Anyboard/anypawn/demo-apps/demo-anyPawn/README.md

# Anyboard Demo App

Demonstrates the basic functioning of the Anyboard Pawn and Printer

## Setup

### Required hardware

- Anybaord Pawn

### Download and install Evothings
- Install [Evothings](https://evothings.com/download/) on your PC/Mac
- Install [Evothings](https://evothings.com/download/) app on your phone.

### Connect to Evothings
- Open Evothing on your PC
- Drag the index.html file into [Evothings](http://evothings.com) workbench.
- Open Evothings app on your phone
- Connect to workbench running on PC
- Run the example app from Evothings Workbench
