Anyboard/anypawn/case/anypawn_colorsensor_mask.stl

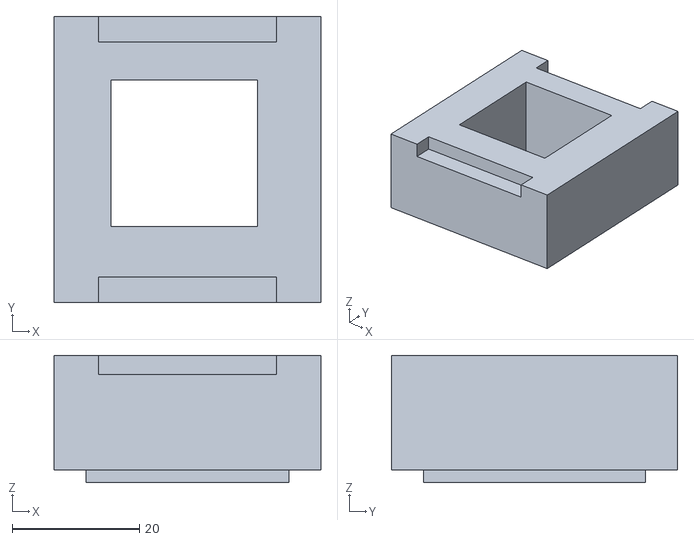
[picture p3: CAD file, 2018-01-28]
case/anypawn_colorsensor_mask.stl
42.0 x 45.0 x 20.0
