Anyboard/anypawn/case/anypawn_case_formlab.stl

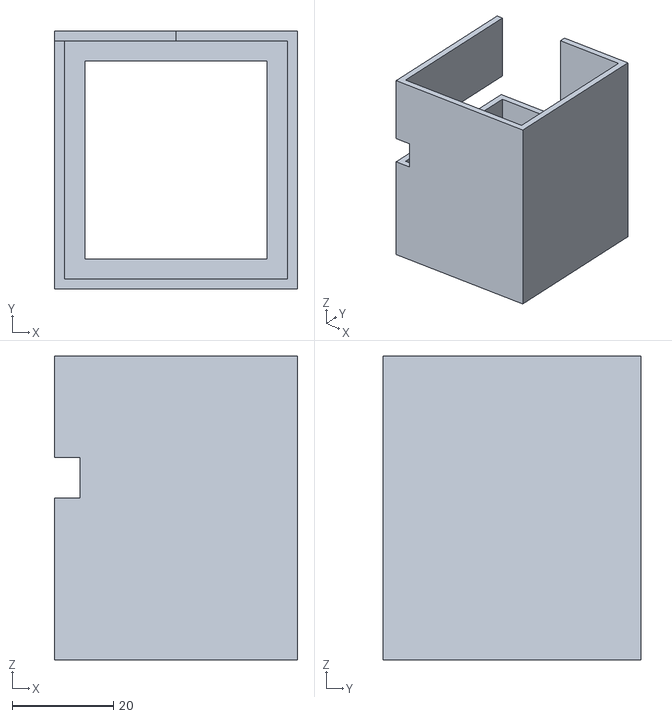
[picture p4: CAD file, 2018-01-28]
case/anypawn_case_formlab.stl
48.0 x 51.0 x 60.0
