Anyboard/anypawn/(list of files, cad)

Other CAD files:
case/anypawn_case_formlab_w_support.stl
