Anyboard/anypawn/Color_template_print.pdf

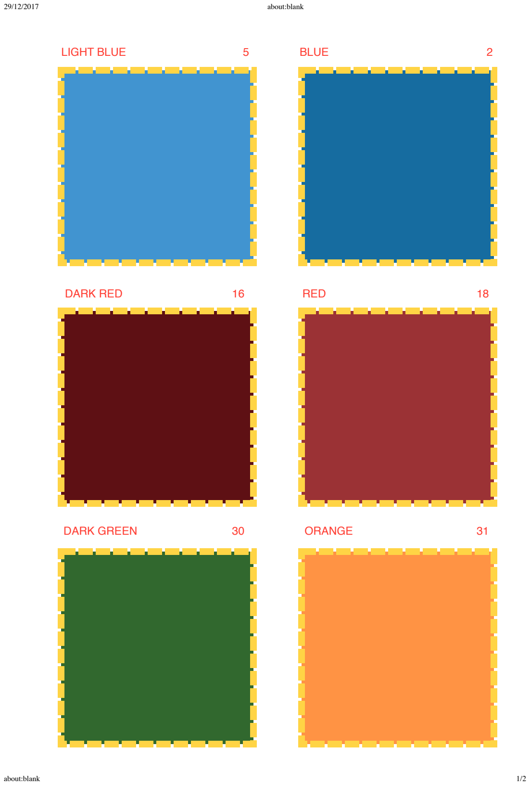
[picture p5: page 1]

29/12/2017 | about:blank
about:blank | 1/2
LIGHT BLUE | 5 | BLUE | 2
DARK RED | 16 | RED | 18
DARK GREEN | 30 | ORANGE | 31

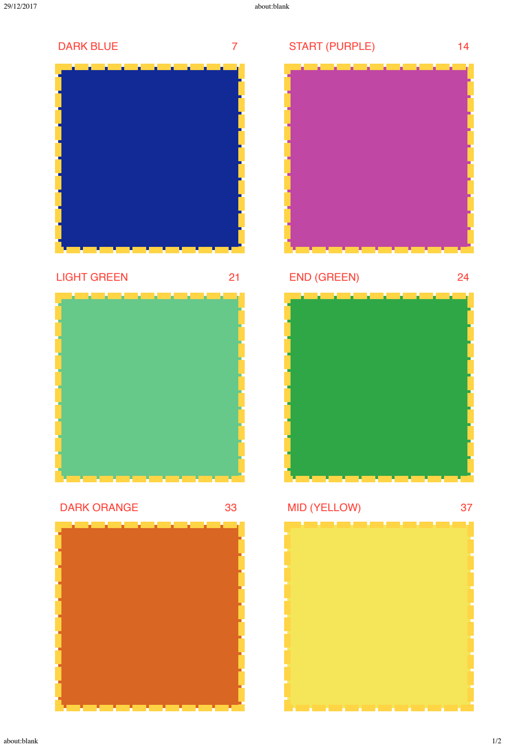
[picture p6: page 2]

29/12/2017 | about:blank
about:blank | 1/2
DARK BLUE | 7 | START (PURPLE) | 14
LIGHT GREEN | 21 | END (GREEN) | 24
DARK ORANGE | 33 | MID (YELLOW) | 37
