Anyboard/anypawn/imgs/printer.jpg

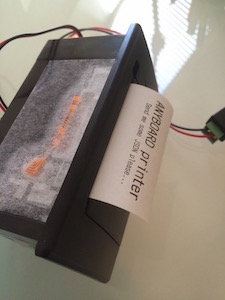
imgs/printer.jpg
