Anyboard/anypawn/Color Calibration/Calibration_ColorSensor_Ink.xlsx

Sheet: Measure All Sectors
Sector | Color Temperature | Clear
1 | 69 | 79
2 | 85 | 97
3 | 81 | 102
4 | 92 | 110
5 | 85 | 110
6 | 64 | 77
7 | 73 | 86
8 | 65 | 93
9 | 70 | 96
10 | 67 | 97
11 | 51 | 70
12 | 42 | 85
13 | 41 | 89
14 | 41 | 102
15 | 36 | 104
16 | 51 | 70
17 | 38 | 82
18 | 36 | 85
19 | 32 | 93
20 | 32 | 96
21 | 58 | 113
22 | 68 | 108
23 | 63 | 103
24 | 57 | 94
25 | 60 | 79
26 | 42 | 112
27 | 44 | 111
28 | 49 | 106
29 | 48 | 98
30 | 54 | 80
31 | 30 | 112
32 | 31 | 110
33 | 30 | 102
34 | 36 | 84
35 | 38 | 88
36 | 32 | 151
37 | 30 | 144
38 | 32 | 129
39 | 38 | 103
40 | 48 | 81

Sheet: Distance Euclidienne
 |  |  | 1 | 2 | 3 | 4 | 5 | 6 | 7 | 8 | 9 | 10 | 11 | 12 | 13 | 14 | 15 | 16 | 17 | 18 | 19 | 20 | 21 | 22 | 23 | 24 | 25 | 26 | 27 | 28 | 29 | 30 | 31 | 32 | 33 | 34 | 35 | 36 | 37 | 38 | 39 | 40 |  |  |  |  | Laser used |  | Ink used
 |  |  | 69 | 85 | 81 | 92 | 85 | 64 | 73 | 65 | 70 | 67 | 51 | 42 | 41 | 41 | 36 | 51 | 38 | 36 | 32 | 32 | 58 | 68 | 63 | 57 | 60 | 42 | 44 | 49 | 48 | 54 | 30 | 31 | 30 | 36 | 38 | 32 | 30 | 32 | 38 | 48 |  | Dmin | 8 | Dmin 8 : | Used | Unused | Used | Unused
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
