Anyboard/anypawn/Color Calibration/Calibration_ColorSensor_Laser.xlsx

Sheet: Measure 1 - Sector 2
Temps - Battery Voltage | Amplitude - Battery Voltage | Gain | Amplitude - Red | Amplitude - Green | Amplitude - Blue | R | G | B |  |  | CT | Clear | Correction | Corrected |  |  | V_BAT | x3 | x2 | x1 | x0 | Correction factor
0 | 3.6 | 4 | 3170 | 5893 | 6351 | 792.5 | 1473.25 | 1587.75 | Reference Value | 83 | 70.1214511 | 110.1 | 0.7538601272 | 83 |  |  | 3.65 | -300.6906901 | 859.94073 | -821.5785 | 263.03 | 0.7015
1 | 3.6 | 4 | 3176 | 5892 | 6357 | 794 | 1473 | 1589.25 |  |  | 70.05510076 | 110.1785714 | 0.7533225284 | 83 | x3 | -6.1836 | 3.64 | -298.2260247 | 855.2351808 | -819.3276 | 263.03 | 0.7116
2 | 3.6 | 4 | 3169 | 5891 | 6349 | 792.25 | 1472.75 | 1587.25 |  |  | 70.12148943 | 110.0642857 | 0.754104744 | 83 | x2 | 64.548 | 3.63 | -295.7748642 | 850.5425412 | -817.0767 | 263.03 | 0.7210
3 | 3.6 | 4 | 3174 | 5891 | 6355 | 793.5 | 1472.75 | 1588.75 |  |  | 70.07718967 | 110.1428571 | 0.7535667964 | 83 | x1 | -225.09 | 3.62 | -293.3371716 | 845.8628112 | -814.8258 | 263.03 | 0.7298
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
